RAPcores/rapcores/boards/README

# Pin Definitions

pin difinitions for different boards

Naming?
