RAPcores/rapcores/docs/index.rst

About
=====

RAPcores is an open source project focused on widely deployable FPGA and ASIC hardware 
for high performance closed-loop motor control. RAPcores stands for
Robotic Application Processing Cores.

Contents
--------

.. toctree::
   :maxdepth: 2

   releases
   interfaces
   spi_spec
   register_map
   configuration
   motor_control
   librapcore
   asic
   dev
   internals
