RAPcores/rapcores/docs/librapcore.md

## librapcore

librapcore is the C driver library targeting Linux and embedded devices.

Docs will go here...
