RAPcores/rapcores/(threads)

Thread 2 (2020-07-27):

SPI Protocol Spec

sjkelly, 2020-07-27:
Via Alden:

The following needs to be transferred from the firmware to the FPGA (down) on a per-segment basis

- clock_ticks/segment (32 bit, unsigned) - sets the length of the segment
- direction bit word. Assuming a 6 axis device, that’s 6 bits. Fits in a byte, or a 32bit word if symmetry is required

- per motor. (Assume 6 - for example)
  - sub-step increment (32 bit, unsigned) Sets step rate relative to stepper clock
  - sub-step increment increment (32 bit, signed)
      Sets linear acceleration per step by adjusting sub-step increment up or down

So that’s 14 x 32 bit words = 448 bits

The following should be returned per segment
- per motor
   - incremental shaft encoder reading of previous segment
   - incremental effector encoder reading of previous segment

That’s 12 x 32 bit words returned per transfer. This can be clocked in the SPI back- channel. You have up to 64 bits that can be padded to allow for encoder read setup time if required.

At 1 Mbps that’s 2232 transfers per second (idealized - reality would be a bit slower)
At 8 Mbps that’s 17857 transfers per second
At 25 Mbps that’s 55803 transfers per second

This could very reasonably be handled by a 8 Mbps SPI data rate and still achieve very good update times. Minimum theoretical segment time would be 56 uSec at this rate. We would probably want to run more like 250 uSec or 125 uSec

FYI: Steve's Google doc notes
https://docs.google.com/document/d/1CBAAlIxWcqdrMcA0QrfrJmAGSGN-QBaauAiughXW1mI/edit

sjkelly, 2021-01-06:
Closing this out since the SPI protocol is now implemented and documented close to what is discussed here. Docs: https://rapcores.github.io/rapcores/spi_spec.html

We can open further issues for more granular discussions.

Closed 2021-01-06.

Thread 3 (2020-07-29):

Quad SPI support

sjkelly, 2020-07-29:
Quad SPI seems to be growing more common, especially on cortex m7. Some FPGAs have hard IP for it, but none of these are in open bitstreams tools yet.

Refs:
- https://embeddedinventor.com/quad-spi-everything-you-need-to-know/

sjkelly, 2021-08-12:
I don't think this will ever happen, unless there is accessible hard IP for it. It makes more sense to jump to PCIe for CPU+RAPcore combos, and plain SPI should be sufficient for most embedded applications. I2C also would be far more marketable as well, making QSPI a too specialized niche to address right now.

Closed 2021-08-12.

Thread 6 (2020-08-13):

Stepper Driver Control

sjkelly, 2020-08-13:
The current code runs commutation on a dual HBridge. For early integration with upstream firmwares we should be able to generate step/dir/enable signals.

Closed 2020-12-17.

Thread 7 (2020-08-13):

Bipolar Stepper Motor Commutator

sjkelly, 2020-08-13:
Desired Features:

### Open Loop:

- [x] Current Limit
- [x] Micro Stepping (256 is target)

### Closed Loop:
- [ ] Current Measurement
- [ ] Skip Detection

sjkelly, 2021-06-11:
We hit 256x microsteps for open loop with SVM current limit. Discussion for closed loop in #149

Closed 2021-06-11.

Thread 23 (2020-09-15):

Maximize use of BRAM on FPGA

sjkelly, 2020-09-15:
At present the parameters for the step timer and commutation tables are inferred as gates. This will very quickly become problematic if microstep count or move buffer size increase. E.g. with the move buffer at 2 we are at ~2400 LUT and with it set to 8 we are at ~4000 LUT. Mind this is for a single axis.

Fortunately Yosys will automatically infer memories without instantiating device specific RAM modules. See: https://github.com/YosysHQ/yosys/issues/1134
To do this we will need to limit the block/word size to 16 bits. This should be achievable in the commutator module by keeping the phase PWM resolution under 16 bit. However there are more gymnastics for the step timer to set strides for 64 bits.

sjkelly, 2021-02-21:
I'm closing this out since we now have the opposite problem:

```
25.22.6. Executing MEMORY_COLLECT pass (generating $mem cells).
Collecting $memrd, $memwr and $meminit for memory `$flatten\spifsm.$genblock$src/spi_state_machine.v:147$846[0].\s0.phase_table' in module `\rapcore':
  $flatten\spifsm.$genblock$src/spi_state_machine.v:147$846[0].\s0.$meminit$\phase_table$src/dual_hbridge.v:0$249 ($meminit)
  $flatten\spifsm.$genblock$src/spi_state_machine.v:147$846[0].\s0.$memrd$\phase_table$src/dual_hbridge.v:108$246 ($memrd)
  $flatten\spifsm.$genblock$src/spi_state_machine.v:147$846[0].\s0.$memrd$\phase_table$src/dual_hbridge.v:109$248 ($memrd)
Collecting $memrd, $memwr and $meminit for memory `$flatten\spifsm.$genblock$src/spi_state_machine.v:147$847[1].\s0.phase_table' in module `\rapcore':
  $flatten\spifsm.$genblock$src/spi_state_machine.v:147$847[1].\s0.$meminit$\phase_table$src/dual_hbridge.v:0$249 ($meminit)
  $flatten\spifsm.$genblock$src/spi_state_machine.v:147$847[1].\s0.$memrd$\phase_table$src/dual_hbridge.v:108$246 ($memrd)
  $flatten\spifsm.$genblock$src/spi_state_machine.v:147$847[1].\s0.$memrd$\phase_table$src/dual_hbridge.v:109$248 ($memrd)
Collecting $memrd, $memwr and $meminit for memory `$flatten\spifsm.$genblock$src/spi_state_machine.v:147$848[2].\s0.phase_table' in module `\rapcore':
  $flatten\spifsm.$genblock$src/spi_state_machine.v:147$848[2].\s0.$meminit$\phase_table$src/dual_hbridge.v:0$249 ($meminit)
  $flatten\spifsm.$genblock$src/spi_state_machine.v:147$848[2].\s0.$memrd$\phase_table$src/dual_hbridge.v:108$246 ($memrd)
  $flatten\spifsm.$genblock$src/spi_state_machine.v:147$848[2].\s0.$memrd$\phase_table$src/dual_hbridge.v:109$248 ($memrd)
Collecting $memrd, $memwr and $meminit for memory `$flatten\spifsm.$genblock$src/spi_state_machine.v:147$849[3].\s0.phase_table' in module `\rapcore':
  $flatten\spifsm.$genblock$src/spi_state_machine.v:147$849[3].\s0.$meminit$\phase_table$src/dual_hbridge.v:0$249 ($meminit)
  $flatten\spifsm.$genblock$src/spi_state_machine.v:147$849[3].\s0.$memrd$\phase_table$src/dual_hbridge.v:108$246 ($memrd)
  $flatten\spifsm.$genblock$src/spi_state_machine.v:147$849[3].\s0.$memrd$\phase_table$src/dual_hbridge.v:109$248 ($memrd)
Collecting $memrd, $memwr and $meminit for memory `\spifsm.current' in module `\rapcore':
  $flatten\spifsm.$memwr$\current$src/spi_state_machine.v:0$1084 ($memwr)
  $flatten\spifsm.$memwr$\current$src/spi_state_machine.v:0$1090 ($memwr)
  $flatten\spifsm.$memwr$\current$src/spi_state_machine.v:0$1096 ($memwr)
  $flatten\spifsm.$memwr$\current$src/spi_state_machine.v:0$1104 ($memwr)
  $flatten\spifsm.$memrd$\current$src/spi_state_machine.v:163$1049 ($memrd)
  $flatten\spifsm.$memrd$\current$src/spi_state_machine.v:163$1047 ($memrd)
  $flatten\spifsm.$memrd$\current$src/spi_state_machine.v:163$1045 ($memrd)
  $flatten\spifsm.$memrd$\current$src/spi_state_machine.v:163$1043 ($memrd)
Collecting $memrd, $memwr and $meminit for memory `\spifsm.dir_r' in module `\rapcore':
  $flatten\spifsm.$memwr$\dir_r$src/spi_state_machine.v:0$1075 ($memwr)
  $flatten\spifsm.$memwr$\dir_r$src/spi_state_machine.v:0$1103 ($memwr)
  $flatten\spifsm.$memrd$\dir_r$src/spi_state_machine.v:113$909 ($memrd)
Collecting $memrd, $memwr and $meminit for memory `\spifsm.increment' in module `\rapcore':
  $flatten\spifsm.$memwr$\increment$src/spi_state_machine.v:0$1079 ($memwr)
  $flatten\spifsm.$memwr$\increment$src/spi_state_machine.v:0$1080 ($memwr)
  $flatten\spifsm.$memwr$\increment$src/spi_state_machine.v:0$1085 ($memwr)
  $flatten\spifsm.$memwr$\increment$src/spi_state_machine.v:0$1086 ($memwr)
  $flatten\spifsm.$memwr$\increment$src/spi_state_machine.v:0$1091 ($memwr)
  $flatten\spifsm.$memwr$\increment$src/spi_state_machine.v:0$1092 ($memwr)
  $flatten\spifsm.$memwr$\increment$src/spi_state_machine.v:0$1097 ($memwr)
  $flatten\spifsm.$memwr$\increment$src/spi_state_machine.v:0$1113 ($memwr)
  $flatten\spifsm.$memrd$\increment$src/spi_state_machine.v:97$1069 ($memrd)
  $flatten\spifsm.$memrd$\increment$src/spi_state_machine.v:97$1063 ($memrd)
  $flatten\spifsm.$memrd$\increment$src/spi_state_machine.v:97$1057 ($memrd)
  $flatten\spifsm.$memrd$\increment$src/spi_state_machine.v:97$1051 ($memrd)
Collecting $memrd, $memwr and $meminit for memory `\spifsm.incrementincrement' in module `\rapcore':
  $flatten\spifsm.$memwr$\incrementincrement$src/spi_state_machine.v:0$1081 ($memwr)
  $flatten\spifsm.$memwr$\incrementincrement$src/spi_state_machine.v:0$1082 ($memwr)
  $flatten\spifsm.$memwr$\incrementincrement$src/spi_state_machine.v:0$1087 ($memwr)
  $flatten\spifsm.$memwr$\incrementincrement$src/spi_state_machine.v:0$1088 ($memwr)
  $flatten\spifsm.$memwr$\incrementincrement$src/spi_state_machine.v:0$1093 ($memwr)
  $flatten\spifsm.$memwr$\incrementincrement$src/spi_state_machine.v:0$1094 ($memwr)
  $flatten\spifsm.$memwr$\incrementincrement$src/spi_state_machine.v:0$1099 ($memwr)
  $flatten\spifsm.$memwr$\incrementincrement$src/spi_state_machine.v:0$1114 ($memwr)
  $flatten\spifsm.$memrd$\incrementincrement$src/spi_state_machine.v:98$1072 ($memrd)
  $flatten\spifsm.$memrd$\incrementincrement$src/spi_state_machine.v:98$1066 ($memrd)
  $flatten\spifsm.$memrd$\incrementincrement$src/spi_state_machine.v:98$1060 ($memrd)
  $flatten\spifsm.$memrd$\incrementincrement$src/spi_state_machine.v:98$1054 ($memrd)
Collecting $memrd, $memwr and $meminit for memory `\spifsm.microsteps' in module `\rapcore':
  $flatten\spifsm.$memwr$\microsteps$src/spi_state_machine.v:0$1083 ($memwr)
  $flatten\spifsm.$memwr$\microsteps$src/spi_state_machine.v:0$1089 ($memwr)
  $flatten\spifsm.$memwr$\microsteps$src/spi_state_machine.v:0$1095 ($memwr)
  $flatten\spifsm.$memwr$\microsteps$src/spi_state_machine.v:0$1105 ($memwr)
  $flatten\spifsm.$memrd$\microsteps$src/spi_state_machine.v:162$1048 ($memrd)
  $flatten\spifsm.$memrd$\microsteps$src/spi_state_machine.v:162$1046 ($memrd)
  $flatten\spifsm.$memrd$\microsteps$src/spi_state_machine.v:162$1044 ($memrd)
  $flatten\spifsm.$memrd$\microsteps$src/spi_state_machine.v:162$1042 ($memrd)
Collecting $memrd, $memwr and $meminit for memory `\spifsm.move_duration' in module `\rapcore':
  $flatten\spifsm.$memwr$\move_duration$src/spi_state_machine.v:0$1077 ($memwr)
  $flatten\spifsm.$memwr$\move_duration$src/spi_state_machine.v:0$1106 ($memwr)
  $flatten\spifsm.$memrd$\move_duration$src/spi_state_machine.v:89$908 ($memrd)
```

Closed 2021-02-21.

Thread 44 (2020-10-21):

Switch some Bits to 32 bit

sjkelly, 2020-10-21:
Some rough math on encoders:

```
julia> 2^32/10000 # 10k CPR encoder
429496.7296
```
That covers 429 meters of travel at 1mm/rev.

The SPI protocol in master is not inline with the [proposed spec](https://github.com/RAPcores/Ulticores/wiki/MSG-0x01:-coordinated_segment) either. Master is a separate 64 bit word for duration and 54 bits for direction.

sjkelly, 2021-02-12:
Mostly addressed. Will need some config cleanup (part of define -> parameter transition), but the overrides are there.

Closed 2021-02-12.

Thread 47 (2020-10-23):

Status Words

sjkelly, 2020-10-23:
These will be for all transactions so they have to be general:

<table>
<tr>
<th rowspan="2">I/O</th>
<th colspan="8">Word 1 (Control / Status)</th>
</tr>
<tr>
<th>B1</th> <th>B2</th> <th>B3</th> <th>B4</th> <th>B5</th> <th>B6</th> <th>B7</th> <th>B8</th>
</tr>

<!-- left header-->
<tr><th>CO</th>

<!-- word 1-->
<td><code>0x01</code></td>
<td><code>RESERVED</code></td>
<td><code>0bPONM_LKJI</code></td>
<td><code>0bHGFE_DCBA</code></td>
<td colspan="4"><code>dda_ticks</code></td>

</tr>

<tr>
<!-- left header-->
<th>CI</th>

<!-- word 1-->
<td colspan="1">Status word is TBD</td>

<td colspan="1">Status word is TBD</td>
<td colspan="1">Status word is TBD</td>

<td colspan="1">Status word is TBD</td>
<td colspan="1">Status word is TBD</td>
<td colspan="1">Status word is TBD</td>
<td colspan="1">Status word is TBD</td>
<td colspan="1">Number of available buffer spaces</td>
</tr>
</table>

sjkelly, 2021-07-19:
We have a status register now that is an alternative solution to this. We can still add status words as part of the header transaction over SPI, but it is a special case, and not strictly required for our needs.

Closed 2021-07-19.

Thread 76 (2020-12-03):

RAM Memory Mapping and Module Communication (for Buffering)

sjkelly, 2020-12-03:
So far I think we have got our bearings on how to use the distributed block RAMs on the FPGA. However, there are also larger memories available. Now going through the process of ASIC hardening and modularization has lead to some potential insights:

- We have alot of memories and wide registers
- We will only have more of these as we get to MVP
- The initialization of registers is mostly zero, but in some cases it is a constant

OpenRAM docs and technology: https://vlsida.github.io/OpenRAM/

IIUC, BRAM in FPGA is pre-initialized at bitstream load so it almost behaves like a register. I'm not sure what pre-initialized OpenRAM memory would look like and require.

The benefits of RAM over distributed registers (FPGA and ASIC):
- Structure in ASIC and density -> less die area
- Known timing behaviours
- Validated on a given technology process
- Possibly fewer gates within a module

However they likely need to be:
- Initialized
- Manually Placed (in the ASIC hardening process)
- Controlled both at the ASIC level and high-level state machine level

Now in several spots we have a pseudo-memory -> register hierarchy. Examples: Cosine, DDA Timer (parameter load from double buffer). In most cases they are BRAMs or all registers. Successfully utilizing BRAMs in all these cases could be a simple demonstration of what is needed. E.g. if BRAMs work we may have a mapping from FPGA -> ASIC via OpenRAM.

That is where I am at now in understanding this. As to what needs to be done; this is not yet clear to me. I suspect when we have RV32 integration it will be more clear about how to handle transfers and events. This should give clarity on memory mapping between RV32<->RAPcore as well.

This is slightly different from #23 because this is more to the ASIC hardening process. #23 is a prerequisite for these things.

sjkelly, 2021-02-21:
This is addressed with RAM use at the moment. The alternative of using a bus is #128

Closed 2021-02-21.

Thread 81 (2020-12-07):

Formal is not running for Ultibridge

sjkelly, 2020-12-07:

sjkelly, 2021-02-24:
This and #83... Symbiyosys is effectively a wrapper over `yosys` and `yosys-smtbmc`. Possible option may be to extract the flow so that it fits into our build system better and we can change out configs.

sjkelly, 2021-02-24:
Or just append the board defines like so: https://symbiyosys.readthedocs.io/en/latest/reference.html#file-sections

Closed 2021-02-24.

Thread 83 (2020-12-07):

Remake formal board specific

sjkelly, 2020-12-07:
Seemed like a good idea at the time. Then i blew up my board.

Closed 2021-02-24.

Thread 114 (2020-12-21):

In-tree ASIC/FPGA synthesis+techmap for test benches

sjkelly, 2020-12-21:
This would be helpful for high-level isolated gate-level tests outside openlane or other open source PDK flows.
Examples: https://github.com/YosysHQ/yosys/tree/master/examples/osu035

We would likely need to use open_pdks to get the liberty files for ABC using Skywater.

Uncertainties:
- Powered Verilog
- EDIF to verilog (netgen?)
- GL synth/TB is possible for ASIC. Same for FPGA?
- Prebuilt liberty files?

Slight prerequisite for this is #42 such that we have self-checking test benches.

sjkelly, 2021-03-06:
Waiting pays:

sjkelly, 2021-03-06:
https://github.com/efabless/skywater-pdk-libs-sky130_fd_sc_hd

Thread 118 (2020-12-23):

Document Release Process

sjkelly, 2020-12-23:
With the skywater shuttle out there now we officially have a deployment target for 0.1. In order to address some current issues and continue development, we need to break naming on some files while also stabilizing and testing the skywater deployment.

Since we have committed to semantic versioning a 'main/develop' give insufficient space for all possible versions.

Rough guideline:
- `main` -> active development branch
- `release-M.m` -> stabilized/frozen release branches

So e.g. we branch off main as `release-0.1`. Main now targets 0.2 active development. Changes/patches from 0.2 that are API compatible can be backported to the `release-0.1` branch. In this case a new patch release is made such as `0.1.0` -> `0.1.1`.

sjkelly, 2021-01-06:
#125

Closed 2021-01-06.

Thread 120 (2020-12-23):

Step out signal too short a length

johnnyr, 2020-12-23:
The Step out signal is very short. We should probably make the signal be on for multiple clock cycles.

aldenhart, 2020-12-23:
Most drivers require at least 1uS, and 10uS is a better comfort zone. SOme really old drivers (like some Toshibas) want even more than that.

sjkelly, 2021-01-15:
Some datasheet surfing:

| Part | Min Step High (ns)|
|-------|--------------------------|
| A4988 | 1000 |
|TMC2160| 100|
|DRV8825| 1900|

With #130 the pulse duration is 1/(DDA tick) currently set to 400khz so 2500ns.

Closed 2021-01-15.

Thread 128 (2021-01-08):

Inter-Module Configuration passing

sjkelly, 2021-01-08:
Current work on multiaxis support is leading to some issues with passing configurations between modules. This is likely part of our on-going understanding of how to use memories effectively and RTL design patterns. There was some offline discussion of an inter-module bus architecture. The downsides are this may add additional gates/LUTs. The upside is this would greatly simplify macrofying a driver module on ASIC.

Filing this as an issue because it is likely best to get multi axis in ASAP for integration test and hack around this until we find a proper solution.

sjkelly, 2021-02-15:
Somewhat philosophical point:
Verilog Modules are intended (at least as far as I can tell) to be logical abstractions and physical black boxes. Now for ASIC hardening we need to plan somewhat in advance what we want to harden separately. During the eFabless MPW-one we tried both a hyper-modularized approach, somewhere inbetween, and a "monolith". Ultimately the monolith was shipped, but I think that we all agreed that it was not a satisfying solution.

The core issue with the FSM and modularization is that *memories cannot be passed in and out of modules*. To really get multiaxis into the protocol we need either a bus on each module to pass configuration or we need to instantiate them alongside the FSM. Instantiating along side the FSM is the simplest solution and likely uses the fewest resources. A bus is satisfying from a re-use and validation standpoint.

I am proposing we punt the bus issue to work on the SPI user-facing APIs, and make the statemachine at the top-level again. So leave this an open issue, but fix the core issue which is getting per-axis parameters (such as current and microsteps) supported ASAP.

sjkelly, 2021-05-08:
The module layout we have now works well, and is similar to what was described in my last comment. I think some modules may eventually warrant their own bus, but for now everything is arranged such that the memories work well for multi axis control. We will eventually need some way of using and managing these memories more effectively, but the root issue here is addressed.

Closed 2021-05-08.

Thread 134 (2021-01-16):

[DDA] Flip substep acculumator on direction change

sjkelly, 2021-01-16:
https://github.com/synthetos/g2/blob/441003f36ed4fc13a7ddefb61c0db4fecc67a463/g2core/stepper.cpp#L521-L529

Closed 2021-07-19.

Thread 146 (2021-02-12):

Jitter in DDA

sjkelly, 2021-02-12:
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

with `make yosys-rapcore` on sjk/ms1 branch.

Closed 2021-02-20.

Thread 148 (2021-02-16):

Encoder and Microstep Modulus

sjkelly, 2021-02-16:
e.g. for a 1000cpr encoder with 200 steps/rev and 64 microsteps we have 64 microsteps and 5 encoder ticks per full step then 12.8 microsteps per encoder tick.

We could possible handle a few ways:
- Microsteps become divisible by 10 e.g. 60 microsteps
- Use a lookup table for phasing increments e.g. {12, 13, 13, 13, 13} for the above example
- Compressed version of the above, in words "13 microsteps per tick, but every 4 ticks it is 12".

None of these seem satisfactory, hence an issue to noodle and get some comments.

Thread 149 (2021-02-17):

Closed Loop Modes

sjkelly, 2021-02-17:
Some ideas of parameters for closed loop:

Vector space
- Square (will detent, but better holding torque)
- Circle (smooth in theory)

Over Torque
- Throttle all motor channels ( not sure how to do)

Positioning
- Phase hold (normal)
- FOC (unstable)
- "Soft" allow a deadband of +/- 90 degrees

Current bounds
- Min/Max

Thread 153 (2021-02-20):

Explicit Motion Timing Protocols and Current Controllers

sjkelly, 2021-02-20:
With the microstepping work on main we now have the ability to dynamically alter currents as part of motion planning. The current DDA could be expanded to support these modes. An alternative that may dovetail better with other firmwares and frameworks would be an explicit timing mode (whereas DDA is an implicit form). We would need to specify:

- Duration
- Clock ticks/step
- Delta clock ticks/step
- Initial current
- Delta current/step

Wild Speculation:

The main hypothesis is that we are better served using high level dynamics modeling to regulate current (as an analogue for joint torques). Part of this is that the state space for torque control on the motor is two dimensional (rotation and vector length), making a simple PID controller inadequate. PID is sufficient for isolated cases, but we know from low-cost servo options that PID suffers from instability at given velocity windows.

For BLDC this issue is alleviated to some extent by driving the motor at high RPM with high gear ratios. Steppers cannot do this. Moreover, FOC on a stepper has far fewer encoder ticks per electrical cycle (or phase) than a BLDC. This means the error term derived from the encoder is far lower resolution than the number of divisions of our space vector (e.g 5 ticks vs 64 microsteps).

That is not to say controllers in rapcores is not possible or valuable. One approach in rapcores maybe to use a PID or other simple controller to alter the current vector if the encoder is showing lag in the system due to load as a last resort. We will still need an external controller to adjust the velocities and torques periodically (e.g control the angle element of the controls problem). But I think a far more powerful approach is to develop a state space from the torque data during a move to improve the dynamics models on the fly, obviating the need for a controller in rapcores. Given a 1khz update rate we will generate gigs of data that could be used to implement this type of controller.

Links:

- https://www.machinedesign.com/automation-iiot/article/21826706/20-minute-tuneup-zoning-in-on-position-loops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,calculate%20the%20corresponding%20following%20error.&text=The%20greater%20the%20position%20error,a%20direction%20reducing%20the%20error.
- https://www.machinedesign.com/automation-iiot/article/21828255/20-minute-tuneup-put-a-pid-on-it
- https://www.machinedesign.com/home/contact/21838863/motion-system-design

sjkelly, 2021-02-21:
XRef #149

Adding to 0.2 milestone

sjkelly, 2021-05-08:
I'm was conflating two things here. Fixed point is not antithetical to current interpolation, so my reasoning is flawed. Also increasing the DDA base frequency would address my point of BLDC drive frequency as well. Upon more investigation, fixed point is the only way to achieve good precision. I think when I wrote this I was worried that LUT use of the DDA would prevent additional control parameters and I was looking at simpler examples. LUT use shouldn't be a hard constraint yet. Since this issue, we have documented some basic stepper motor models, so the controls intuition I originally wrote here is mostly correct, but it is a subset of wider control solutions. We may let the path planning software implement a control, or we can do onboard, both are valid. Nothing is concretely actionable here or a real concern anymore, so I am closing.

Closed 2021-05-08.

Thread 168 (2021-02-26):

SPI Tristate Broken on Gowin

sjkelly, 2021-02-26:
Title

Thread 170 (2021-02-27):

Upstream Issues notes

sjkelly, 2021-02-27:
Should probably file these upstream (yosys, nextpnr, etc). Most will need minimal repros:

- [ ] Ice40 PLL/Package issues (#152)
- [ ] VCD outputs incorrect wire width when resized via parameter

Thread 171 (2021-02-27):

32 Bit protocol variant

sjkelly, 2021-02-27:
Starting the work on this, for the sake of testing if we parameterized everything well (we are close) and try to find some bugs (I did). Speculative bonus is fewer gates and more throughput.

Implications are minimal. Some wide instructions such as microstepper config use the full 56 bits (64 - 8 for header). DDA etc only loose precision. Of course the current DDA motor support will also drop from 56 motors to 24.

sjkelly, 2021-04-16:
I don't think this makes sense to support at this point in SPI. 64 bit internal words on the FSM are likely to be okay. The original idea was to better abstract the communication layer from the FSM, which is now finished.

Closed 2021-04-16.

Thread 172 (2021-03-01):

SPI Bus Issues

sjkelly, 2021-03-01:
https://github.com/RAPcores/rapcores/commit/1153917c83957df55c1a7e642a8e2507e588b8aa

Thread 183 (2021-03-22):

Encoder Velocity and Acceleration Estimates

sjkelly, 2021-03-22:
Will likely be useful for solving for Inertia and dampening. Also we should be able to trivially do stall detection with a velocity threshold.

From our example Frequency table for Prusa MK3s the homing full step frequency is 300Hz. which gives us 1.5kHz using a 1000 cpr encoder. Assuming constant velocity, if in a 1/1500 second period (likely + some error bound) occurs without a position update we can infer a stall.

Thread 189 (2021-04-01):

Apply Microsteps as a denominator rather than quotient

sjkelly, 2021-04-01:
We currently do this:
```
  // Set the increment across the phase table from the specified microsteps
  wire [7:0] abs_increment = (microsteps == 8'd0 ) ? 8'd64 :
                             (microsteps <= 8'd2 ) ? 8'd32 :
                             (microsteps <= 8'd4 ) ? 8'd16 :
                             (microsteps <= 8'd8 ) ? 8'd8  :
                             (microsteps <= 8'd16) ? 8'd4  :
                             (microsteps <= 8'd32) ? 8'd2  :
                                                     8'd1  ;
```

In theory non power of two increments should work in LUT traversal. so you could e.g. get 64/3 microsteps. Which might be useful for encoders and also less FPGA logic.

sjkelly, 2021-04-01:
This is a proposed solution for #148

Closed 2021-04-03.

Thread 190 (2021-04-01):

VFD Starting Coils - Observations

sjkelly, 2021-04-01:
While making the SVM parametric I realized we are close to making a VFD. I have a motor from a fan here that has a starting coil. Some observations:

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

Here the Primary (blue) has a much greater magnitude than the starting coil in red with a slight phase shift.

For the SVM to be suitable for one phase VFD with starting coils we will likely need to apply different current scaling to each coil and arbitrary phase shifts.

sjkelly, 2021-07-27:
SVM is now able to handle this by making the amplitude a vector.

Closed 2021-07-27.

Thread 191 (2021-04-05):

CRC and/or 8b/10b encoding

sjkelly, 2021-04-05:
I'm running some simple checks since we now have librapcores for high throughput transfers. I'm observing relatively high error rates on the bench of ~1-2%. The hardware setup is non-ideal, long cables, etc. This should be a good worst-case for error correction tests. After looking at some other devices I am noticing CRC is commonly used for user-space protocols.

8b/10b is also used with CRC, but it appears generally at physical layers and it high end buses like PCIe and USB3, so it may be expensive to do this in software. OTOH, 8b/10b could just be a lookup table ~1kB and may still achieve good performance for processors with sufficient cache, but I'm not sure things like microcontrollers would be able to do this well. So far I have not seen this done in userspace software, so it would be experimental and risky. We will likely want to revisit this at some point.

The issues and risks to CRC are the transfer process. Since we have "stream" modes such as coordinated moves, we need to be certain the header is ACK before proceeding with the stream payload, or we may accidentally trigger a different mode in the state machine. It is therefore likely easiest to do CRC on each 64bit word at a time. The performance implications of this in host controller software will need to be quantified some how. On the gateware sides of things this can be done non-combinatorially (see pony link below), so we should not introduce latency on the peripheral side of things. Gateware should also have no state machine changes, with CRC checks and error handling residing in the SPI bus module.

A good reference for a CRC + 8b/10b protocol with Verilog and C code: https://github.com/cliffordwolf/PonyLink

sjkelly, 2021-04-05:
Verilog CRC generator:

http://outputlogic.com/?page_id=321

Thread 202 (2021-05-06):

Three Phase SVM Alignment

sjkelly, 2021-05-06:
Currently we center align all 'N' phases requested of the SVM. This is AFAIK incorrect for three phase by the property that A+B+C=0, U+V+W=0. In any given point of the three-phase electrical cycle, two phases should sign match. So these likely need to be "stacked" in some form such that they are equal to the single opposite signed phase.

What we have:
```
    // A: |-------|____
    // B: ___|-|_______
    // C: _|-----|_____
```

What we need:
```
    // A: |--------|___
    // B: ____|-|___
    // C: |-----|_____
```

sjkelly, 2021-05-06:
e.g:
https://github.com/bgkatz/motorcontrol/blob/2fa6cabbebcb19efb9d6b2dd0f59edc3537ad64f/Core/Src/foc.c#L96-L107

sjkelly, 2021-05-13:
We also need the DQ transform from here: https://github.com/bgkatz/motorcontrol/blob/2fa6cabbebcb19efb9d6b2dd0f59edc3537ad64f/Core/Src/foc.c#L83-L94

Thread 205 (2021-05-11):

Register Map

sjkelly, 2021-05-11:
With the recent work to use parametric style verilog, I believe there is a stronger case for https://github.com/RAPcores/rapcores/pull/154. The root issue of that approach is that most data was made redundant. Only certain things are true "memories" in RAPcores, namely: DDA buffer, and microstep tables. Everything else is registers, so efficient memory packing and extraction should not save any gates.

However, I suspect that this memory-packed approach is still correct, and may be generalized to a net benefit. To achieve this benefit, the state machine and protocol will likely need to be changed out into a true "register" model that uses this packed memory structure. The key savings will be a slimmed-down FSM that simply writes to a memory address. I've been nibbling around the edges of this idea for a few months now under the auspice of a "async" state machine. The reality is we are already async, but I realize now we may rework the protocol to maintain the same latency and bandwidth balance with a greatly reduced FSM complexity.

The approximate approach is as follow:
Header Modifications:
- Eliminate any data transfer in the header.
- Add Read/Write Flags to the header
- Add a transfer length field

This is more similar to SPI flash interfaces.

Next we will have to:
- Construct a parametric register map with localparam offsets.
- Communicate alignment/register locations to `librapcores`

The combination of these should make the main communication state machine only require a few states, rather than the "state-per-command" as implemented currently.
Moreover, values that do no require registers (such as the aforementioned offsets, version numbers, configuration data, etc) will also be elided as memory access (rather than wasting LUT like we do currently).

Of course its hard to completely eliminate the complexity, we just shove it somewhere else. Librapcores will need to handle these offsets. Fortunately though, I think doing this on CPU is a much better place than in gateware as we do now.

sjkelly, 2021-05-17:
I did some more research on this over the weekend, and was pretty inspired by the Friday OpenFPGA presentations. The wishbone bus transaction state (or any SoC bus) is close to what we want for minimal footprint and device utilization (Address, Data In, Data Out, Read/Write flag, ACK, etc)  The difference is we have different event timing with SPI and are missing a dedicated address line. However, an internal wishbone bus is likely the best long-term pathway here for future integration. For example QuickLogic is using OpenFPGA for all their new products, and we would have a simple pathway to becoming HardIP on an eFPGA if we support Wishbone,  (disclaimer: I'm a QuickLogic shareholder). Same story for PicoSoC, Caravel, etc...

So the objective is multifold:
- We need to test a register mapping strategy to handle more readable and writable registers than the present.
- We need to slim down the FSM
- We should have a strategy for multiple interfaces and protocols
- We should handle memories more effectively than the present
- We need to support SoC/Hard IP integration uses of RAPcores

Internally, it seems like wishbone is likely the lowest common denominator that is easily achievable, and addresses the above. We could use our own internal bus and treat Wishbone/SPI/etc non-preferentially.

However, and one-to-one mapping of Wishbone bus to SPI will not be a good outcome for latency and bandwidth. We therefore will likely need to implement some form of a compressed protocol in any non-wishbone bus (something like described in my prior comments would work nicely for this). This should have minimal impact on SPI operations, however we will need to put more logic in the SPI layers. Most of the SPI protocol layer should consist of simple offset and read/write handling to the bus based on the header packet, so the complexity should be manageable.

Some possible consequences of SPI interfacing with Wishbone:
- While Wishbone does have a 64 bit standard, 32 bit is more common.
- If we allow memory offsets for transmission and reception (e.g. CMD 0x01 when DDA params in, encoders out), we may need two cycles on the FSM.
- Will we actually save anything by simplifying the FSM and later complicating the SPI?

Proposed evolution:
- Start with a basic register map and see if a select grouping of commands can be elided from the FSM.
- Rework SPI protocol along the way to be more memory-oriented
- Rework the `spi_state_machine` to be `wishbone_state_machine` and use 32 bit words internally.

sjkelly, 2021-05-17:
@tonokip suggests that we make the mode like a DMA on the SPI bus. Rather than specify length we do implicit address increments on each preceding word. The address increment is performed until CS is deasserted.

sjkelly, 2021-06-04:
We are heading into murky territory here. This is a good article that echoes much of what I've researched so far:
https://olofkindgren.blogspot.com/2016/11/ip-xact-good-bad-and-outright-madness.html

There are some tools to show what is possible:
https://airhdl.com

Though AirHDL is AXI, not wishbone.

From a project perspective, I am not seeing many opportunities to automate register maps. For example, few opensource SoC have automated register mapping (e.g. generate C Header, Verilog, and Documentation). That is read as "there are no good open source tools for this", and from what I've read "there are no good tools for this" seems also like an accurate statement.

Three things need to be kept accurate:
- Documentation
- C Bindings
- Verilog Code

Doing this manually for now is likely an acceptable practice so we can get this development moving and at least feel _somewhat_ comfortable with the foundation here. Long term, we will likely have to see how this plays out. I will open up a new issue to track automating this while we move forward with a manual implementation.

sjkelly, 2021-06-16:
May be good to also think about how strided access patterns could help here. #212 implements something DMA-like, but the addressing is a mess. WB natively support "granularity" which is like a stride, but for a single transaction.

sjkelly, 2021-06-30:
With #212 merged (and improved since my last comments) I think we have a decent handle on this and can move towards Wishbone/SoC deployments.

Closed 2021-06-30.

Thread 206 (2021-05-11):

Carry Chains and Fixed Point for mixed mode controls

sjkelly, 2021-05-11:
This is a thought experiment around the problem of step timing and commutation. I don't think this is strictly reasonable as described. It is grossly over simplified, but I feel it is worth articulating to elaborate the basic concepts of carry-chains and fixed point, and keep these concepts in mind for future projects and features.

The basic idea of the DDA is to trigger a "rollover" in an accumulator at some fixed point. A well-known form of the DDA in digital design is the Delta Sigma Modulator. Both are types of fixed-point schemes, and important for bresenham algorithms and frequency dividers. A simple 8 bit verilog example:
```
module delta_sigma(clk, PWM_in, PWM_out);
input clk;
input [7:0] PWM_in;
output PWM_out;

reg [8:0] PWM_accumulator;
always @(posedge clk) PWM_accumulator <= PWM_accumulator[7:0] + PWM_in;

assign PWM_out = PWM_accumulator[8];
endmodule
```
Source: https://www.fpga4fun.com/PWM_DAC_2.html

The DDA uses a similar fixed point scheme to generate "step" signals. The key observation here is that these step signals need to be accumulated again somewhere. Currently we use 64 bits for DDA accumulator, or the "sigma" in delta sigma. Likewise we use a N-bit encoder internal to our commutation routines to determine electrical phasing and location. This is done by using the bottom bits of our encoder for quarter-wave electrical phasing, with the next two bits to determine the phase polarities.
E.G.

| Encoder Top Bits | Phase/quadrant | Microstep Phase/ Quarter wave location|
|------------------------|-----------|------------------------------------------------------|
| N Bits                  | 2 Bits    | 8 bits for 256 microsteps                        |

Now, when we increment or decrement the "encoder" we can determine the change to the electrical phase by looking at the 10 bottom bits. However we could simply chain the DDA and electrical encoder into one large register to complete the fixed point scheme:

| Encoder Top Bits | Phase | Microstep Phase/ Quarter wave location| DDA Accumulator |
|------------------------|-----------|------------------------------------------------------|-------------------------|
| N Bits                  | 2 Bits    | 8 bits for 256 microsteps                        |  64 Bits                 |

~With this approach the Fixed Point scheme is fully embedded into the motor commutation, with the side effect of doubling our DDA resolution. For example, so take one step per DDA tick we would add `typemax(UInt64)` to the accumulator, which will increment our microstep phasing by one each tick. To change direction we subtract. Note: this register is behaving as one big 96bit number assuming 32 bits for electrical encoder, and 64 for the accumulator.~

~This seems like a nice simplification, but there are issues. Primarily this does not cleanly handle variable microsteps. It may also make it difficult to add controllers. Both things we need.~

sjkelly, 2021-05-14:
Some clarifications after implementing in #207.

We use 63 bits for the DDA, since the fixed point component is (naturally) unsigned. The DDA input remains a signed 64 bit number, and the rollover behavior should be the same.

Controls should actually be _far_ easier with this approach. We can easily mix explicit and implicit timing domains, since we have both representations in one place now. E.G. if the DDA is controlling we let it set the accumulator. If we are going something based on encoder velocity/accelerations (based on clock ticks/ encoder step) such as a "skate" mode or torque limited we add to the upper bits, rather than the DDA fixed point.

Naturally, our initial controllers will need to be explicit-timed to be resource efficient. However, in the future, our controls could use the DDA and achieve huge orders of magnitude precision increase.

With variable microsteps, one approach is to window-off bits and shift the DDA terms. There are actually a few approaches here we should consider here, but I consider this low priority compared to servo controls.

Following: https://en.wikipedia.org/wiki/Q_(number_format)
We use a Q24.63 number format in #207.

Closed 2021-07-19.

Thread 218 (2021-07-17):

Register Layouts and Parametrics: Blocked Regions

sjkelly, 2021-07-17:
With the base register map work in main, there is still much to do around the documentation and bindings for this work. One issue that seems nice in practice, quickly becomes a headache is parametric register layouts.

Parametric register layouts are not something that helps interoperability towards any end right now. In theory there is some argument about memory savings and so forth. But I think in practice this is minimal advantage, as I will describe below.

For simplicity we add a new parameter for `max_channels`, and cap it at 16 or 32 for example. This way we "block" out memory space for up to a maximum supported motor channel amount. This still allows for some degree of parametrics, but it will be far simpler, and can likely be a constant for a given version series. For different and custom deployments it can easily be changed, assuming headers and so forth are regenerated. Blocking out channel memory should have minimal effect on LUT count, and may only start posing an issue if we are in 32 bit systems close to 4GB RAM (at which point most systems go 64 bit, so rare case to bend over backwards for).

Argument as to why memory savings argument is wrong: Take the statically compiled case. If we set e.g. four motors as the configuration, we can still achieve memory savings even in the blocked cases, by only allocating arrays needed for our motor subset. The only potential issue is we don't have one-to-one memory mapping anymore, but I suspect 99.9% of transactions will happen in the command channel, so it is completely moot. We still achieve the memory savings and so forth.

In deployment with a lot of system RAM (order of gigs), we are only asking for around 2Mb for a one-to-one memory map, which is not a lot.

In reality this is likely a question of where do we want to punt the complexity. Right now we spread it over the whole stack. If we block out multi-channel regions, we move this out of the hardware and into the software (_if it is desired_). For SMBCs, Python, ROS, we don't have to do anything and have made our life easier. For embedded deployments there is some lost optimization in one-to-one memory maps. This is a classic memory/compute tradeoff. Fortunately the scales of data handled here are so small, I think we will be fine in the long run.

Addendum:
The poo-poo complexity is in SPI embedded systems for mostly status and config registers due to loosing a one-to-one map if trying to save memory. Systems where we are soft-core, eFPGA SoC, etc, we don't have any worries here because we are sharing memory space, and any issues are only going to be noticed in 32Bit/4Gb systems mentioned above. As for address width, we may run past 8 bits for CSR using a block approach. So far the only system I have seen with 8 bit address and 32 bit value lines are the QuickLogic. I suspect this is not common, and something that will pose a general issue when trying to target eFPGA-SoC.

So the ask is: What is an acceptable upper bound on motors to support?

sjkelly, 2021-07-17:
I am calling these "blocks", but "regions" is also a common term.

sjkelly, 2021-07-19:
It seems the consensus was that 32 motors should be a sufficient upper bound for motor channel memory regions. This is not a hard limit, but an attempt at ensuring status and config registers can be common for any device under this threshold. Commands and telemetry will still be resized based on the motor count.
cc @tonokip @johnnyr

johnnyr, 2021-07-20:
Yes. That is what I heard also.

sjkelly, 2021-07-25:
Update: 32 motors and 64 encoders. Allowing 2 encoders per channel for series elastic actuators or the "shaft"/"effector" dichotomy.

sjkelly, 2021-07-27:
Some other verbiage that may have helped my initial explanation is virtual vs physical memory. By growing our register allocations, regardless of use, we need more virtual memory space.

Thread 228 (2021-08-15):

Vector Execution Model Documentation

sjkelly, 2021-08-15:
One of the key properties in RAPcores is low (no) jitter/skew across multiple axes. We also produce outputs that allow construction of a Frenet frame, that should satisfy the basic requirements for dynamic analysis and control. These need to be documented.

Thread 229 (2021-08-18):

Phase angle interface and step input

sjkelly, 2021-08-18:
cc @tonokip @johnnyr

One of the tradeoffs that had to be made for fixed point carry chains was the elimination of a simple step and direction interface. As far as I can tell Ultibridge/RAPbo has bit rotted and is broken with the DDA. Synth doesn't complain on CI which I suspect is due to the configuration also having the STEP_INPUT interface enabled.

Conversely on Dual H Bridge drivers the STEP_INPUT is also broken.

sjkelly, 2021-08-18:
I would like to delete the STEP_INPUT all together. It seems unnecessary since the FPGA does a way better job at this, and we have proved out 64 bit precision is very much so feasible on only a few dollar part.

sjkelly, 2021-08-19:
Now if we for some reason have a valid use case for STEP_INPUT we can just add to the fixed point register on each pulse.
