RAPcores/rapcores/src/top.v

`default_nettype none

module top (
    input  CLK,
    `ifdef LED
      output wire [`LED:1] LED,
    `endif
    `ifdef tinyfpgabx
      output USBPU,  // USB pull-up resistor
    `endif
    `ifdef SPI_INTERFACE
      input  SCK,
      input  CS,
      input  COPI,
      output CIPO,
    `endif
    `ifdef DUAL_HBRIDGE
      output wire [`DUAL_HBRIDGE:1] PHASE_A1,  // Phase A
      output wire [`DUAL_HBRIDGE:1] PHASE_A2,  // Phase A
      output wire [`DUAL_HBRIDGE:1] PHASE_B1,  // Phase B
      output wire [`DUAL_HBRIDGE:1] PHASE_B2,  // Phase B
      output wire [`DUAL_HBRIDGE:1] VREF_A,  // VRef
      output wire [`DUAL_HBRIDGE:1] VREF_B,  // VRef
    `endif
    `ifdef ULTIBRIDGE
      output CHARGEPUMP,
      input analog_cmp1,
      output analog_out1,
      input analog_cmp2,
      output analog_out2,
      output wire [`ULTIBRIDGE:1] PHASE_A1,  // Phase A
      output wire [`ULTIBRIDGE:1] PHASE_A2,  // Phase A
      output wire [`ULTIBRIDGE:1] PHASE_B1,  // Phase B
      output wire [`ULTIBRIDGE:1] PHASE_B2,  // Phase B
      output wire [`ULTIBRIDGE:1] PHASE_A1_H,  // Phase A
      output wire [`ULTIBRIDGE:1] PHASE_A2_H,  // Phase A
      output wire [`ULTIBRIDGE:1] PHASE_B1_H,  // Phase B
      output wire [`ULTIBRIDGE:1] PHASE_B2_H,  // Phase B
    `endif
    `ifdef QUAD_ENC
      input [`QUAD_ENC:1] ENC_B,
      input [`QUAD_ENC:1] ENC_A,
    `endif
    `ifdef BUFFER_DTR
      output BUFFER_DTR,
    `endif
    `ifdef MOVE_DONE
      output MOVE_DONE,
    `endif
    `ifdef HALT
      input HALT,
    `endif
    `ifdef STEPINPUT
      input STEPINPUT,
      input DIRINPUT,
    `endif
    `ifdef STEPOUTPUT
      output STEPOUTPUT,
      output DIROUTPUT,
    `endif
);

  // Global Reset (TODO: Make input pin)
  //wire reset;
  //assign reset = 1;
  `ifdef tinyfpgabx
    // drive USB pull-up resistor to '0' to disable USB
    assign USBPU = 0;
  `endif

  `ifdef SPIPLL
    // PLL for SPI Bus
    wire spi_clock;
    wire spipll_locked;
    spi_pll spll (.clock_in(CLK),
                  .clock_out(spi_clock),
                  .locked(spipll_locked));
  `else
    wire spi_clock = CLK;
  `endif

  // Word handler
  // The system operates on 64 bit little endian words
  // This should make it easier to send 64 bit chunks from the host controller
  reg [63:0] word_send_data;
  reg [63:0] word_data_received;
  wire word_received;
  SPIWord word_proc (
                .clk(spi_clock),
                .SCK(SCK),
                .CS(CS),
                .COPI(COPI),
                .CIPO(CIPO),
                .word_send_data(word_send_data),
                .word_received(word_received),
                .word_data_received(word_data_received));

  //Reset
  wire resetn;
  reg [7:0] resetn_counter = 0;
  assign resetn = &resetn_counter;
  always @(posedge CLK) begin
    if (!resetn) resetn_counter <= resetn_counter + 1'b1;
  end
  wire reset = resetn;

  // Stepper Setup
  // TODO: Generate statement?
  reg [2:0] microsteps = 2;
  reg [7:0] current = 140;
  reg [9:0] config_offtime = 810;
  reg [7:0] config_blanktime = 27;
  reg [9:0] config_fastdecay_threshold = 706;
  reg [7:0] config_minimum_on_time = 54;
  reg [10:0] config_current_threshold = 1024;
  reg [7:0] config_chargepump_period = 91;
  reg config_invert_highside = 0;
  reg config_invert_lowside = 0;
  reg [511:0] cos_table;

  initial begin
    cos_table	 [ 	7	 : 	0	 ] = 	255	;
    cos_table	 [ 	15	 : 	8	 ] = 	255	;
    cos_table	 [ 	23	 : 	16	 ] = 	255	;
    cos_table	 [ 	31	 : 	24	 ] = 	254	;
    cos_table	 [ 	39	 : 	32	 ] = 	254	;
    cos_table	 [ 	47	 : 	40	 ] = 	253	;
    cos_table	 [ 	55	 : 	48	 ] = 	252	;
    cos_table	 [ 	63	 : 	56	 ] = 	251	;
    cos_table	 [ 	71	 : 	64	 ] = 	250	;
    cos_table	 [ 	79	 : 	72	 ] = 	249	;
    cos_table	 [ 	87	 : 	80	 ] = 	247	;
    cos_table	 [ 	95	 : 	88	 ] = 	246	;
    cos_table	 [ 	103	 : 	96	 ] = 	244	;
    cos_table	 [ 	111	 : 	104	 ] = 	242	;
    cos_table	 [ 	119	 : 	112	 ] = 	240	;
    cos_table	 [ 	127	 : 	120	 ] = 	238	;
    cos_table	 [ 	135	 : 	128	 ] = 	236	;
    cos_table	 [ 	143	 : 	136	 ] = 	233	;
    cos_table	 [ 	151	 : 	144	 ] = 	231	;
    cos_table	 [ 	159	 : 	152	 ] = 	228	;
    cos_table	 [ 	167	 : 	160	 ] = 	225	;
    cos_table	 [ 	175	 : 	168	 ] = 	222	;
    cos_table	 [ 	183	 : 	176	 ] = 	219	;
    cos_table	 [ 	191	 : 	184	 ] = 	215	;
    cos_table	 [ 	199	 : 	192	 ] = 	212	;
    cos_table	 [ 	207	 : 	200	 ] = 	208	;
    cos_table	 [ 	215	 : 	208	 ] = 	205	;
    cos_table	 [ 	223	 : 	216	 ] = 	201	;
    cos_table	 [ 	231	 : 	224	 ] = 	197	;
    cos_table	 [ 	239	 : 	232	 ] = 	193	;
    cos_table	 [ 	247	 : 	240	 ] = 	189	;
    cos_table	 [ 	255	 : 	248	 ] = 	185	;
    cos_table	 [ 	263	 : 	256	 ] = 	180	;
    cos_table	 [ 	271	 : 	264	 ] = 	176	;
    cos_table	 [ 	279	 : 	272	 ] = 	171	;
    cos_table	 [ 	287	 : 	280	 ] = 	167	;
    cos_table	 [ 	295	 : 	288	 ] = 	162	;
    cos_table	 [ 	303	 : 	296	 ] = 	157	;
    cos_table	 [ 	311	 : 	304	 ] = 	152	;
    cos_table	 [ 	319	 : 	312	 ] = 	147	;
    cos_table	 [ 	327	 : 	320	 ] = 	142	;
    cos_table	 [ 	335	 : 	328	 ] = 	136	;
    cos_table	 [ 	343	 : 	336	 ] = 	131	;
    cos_table	 [ 	351	 : 	344	 ] = 	126	;
    cos_table	 [ 	359	 : 	352	 ] = 	120	;
    cos_table	 [ 	367	 : 	360	 ] = 	115	;
    cos_table	 [ 	375	 : 	368	 ] = 	109	;
    cos_table	 [ 	383	 : 	376	 ] = 	103	;
    cos_table	 [ 	391	 : 	384	 ] = 	98	;
    cos_table	 [ 	399	 : 	392	 ] = 	92	;
    cos_table	 [ 	407	 : 	400	 ] = 	86	;
    cos_table	 [ 	415	 : 	408	 ] = 	80	;
    cos_table	 [ 	423	 : 	416	 ] = 	74	;
    cos_table	 [ 	431	 : 	424	 ] = 	68	;
    cos_table	 [ 	439	 : 	432	 ] = 	62	;
    cos_table	 [ 	447	 : 	440	 ] = 	56	;
    cos_table	 [ 	455	 : 	448	 ] = 	50	;
    cos_table	 [ 	463	 : 	456	 ] = 	44	;
    cos_table	 [ 	471	 : 	464	 ] = 	37	;
    cos_table	 [ 	479	 : 	472	 ] = 	31	;
    cos_table	 [ 	487	 : 	480	 ] = 	25	;
    cos_table	 [ 	495	 : 	488	 ] = 	19	;
    cos_table	 [ 	503	 : 	496	 ] = 	13	;
    cos_table	 [ 	511	 : 	504	 ] = 	6	;
  end

  wire step;
  wire dir;
  reg enable;

  `ifdef DUAL_HBRIDGE
  DualHBridge s0 (.phase_a1 (PHASE_A1[1]),
                .phase_a2 (PHASE_A2[1]),
                .phase_b1 (PHASE_B1[1]),
                .phase_b2 (PHASE_B2[1]),
                .vref_a (VREF_A[1]),
                .vref_b (VREF_B[1]),
                .step (step),
                .dir (dir),
                .enable (enable),
                .microsteps (microsteps),
                .current (current),
                .microsteps (microsteps));
  `endif

  `ifdef ULTIBRIDGE
    microstepper_top microstepper0(
      .clk(CLK),
      .resetn( resetn),
      .s_l ({PHASE_B2[1], PHASE_B1[1], PHASE_A2[1], PHASE_A1[1]}),
      .s_h ({PHASE_B2_H[1], PHASE_B1_H[1], PHASE_A2_H[1], PHASE_A1_H[1]}),
      .analog_cmp1 (analog_cmp1),
      .analog_out1 (analog_out1),
      .analog_cmp2 (analog_cmp2),
      .analog_out2 (analog_out2),
      .chargepump_pin (CHARGEPUMP),
      .config_offtime (config_offtime),
      .config_blanktime (config_blanktime),
      .config_fastdecay_threshold (config_fastdecay_threshold),
      .config_minimum_on_time (config_minimum_on_time),
      .config_current_threshold (config_current_threshold),
      .config_chargepump_period (config_chargepump_period),
      .config_invert_highside (config_invert_highside),
      .config_invert_lowside (config_invert_lowside),
      .cos_table (cos_table),
      .step (step),
      .dir (dir),
      .enable(enable),
      );
  `endif


  //
  // Encoder
  //
  reg signed [63:0] encoder_count;
  reg signed [63:0] encoder_store; // Snapshot for SPI comms
  reg [7:0] encoder_multiplier = 1;
  wire encoder_fault;
  `ifdef QUAD_ENC
    // TODO: For ... generate
    quad_enc #(.encbits(64)) encoder0
    (
      .resetn(reset),
      .clk(CLK),
      .a(ENC_A[1]),
      .b(ENC_B[1]),
      .faultn(encoder_fault),
      .count(encoder_count),
      .multiplier(encoder_multiplier));
  `endif

  //
  // State Machine for handling SPI Messages
  //

  reg [7:0] message_word_count = 0;
  reg [7:0] message_header;
  reg [`MOVE_BUFFER_BITS:0] writemoveind = 0;

  // check if the Header indicated multi-word transfer
  wire awaiting_more_words = (message_header == `CMD_COORDINATED_STEP) |
                             (message_header == `CMD_API_VERSION);

  always @(posedge word_received) begin

    // Zero out send data register
    word_send_data <= 64'b0;

    // Header Processing
    if (!awaiting_more_words) begin

      // Save CMD header incase multi word transaction
      message_header <= word_data_received[63:56]; // Header is 8 MSB

      // First word so message count zero
      message_word_count <= 1;

      case (word_data_received[63:56])

        // Coordinated Move
        `CMD_COORDINATED_STEP: begin

          // Get Direction Bits
          dir_r[writemoveind] <= word_data_received[0];

          // Store encoder values across all axes Now
          encoder_store <= encoder_count;

        end

        // Motor Enable/disable
        `CMD_MOTOR_ENABLE: begin
          enable <= word_data_received[0];
        end

        // Clock divisor (24 bit)
        `CMD_CLK_DIVISOR: begin
          clock_divisor[7:0] <= word_data_received[7:0];
        end

        // Set Microstepping
        `CMD_MOTORCONFIG: begin
          // TODO needs to be power of two
          current[7:0] <= word_data_received[15:8];
          microsteps[2:0] <= word_data_received[2:0];
        end

        // Set Microstepping Parameters
        `CMD_MICROSTEPPER_CONFIG: begin
          config_offtime[9:0] <= word_data_received[39:30];
          config_blanktime[7:0] <= word_data_received[29:22];
          config_fastdecay_threshold[9:0] <= word_data_received[21:12];
          config_minimum_on_time[7:0] <= word_data_received[18:11];
          config_current_threshold[10:0] <= word_data_received[10:0];
        end

        // Set chargepump period
        `CMD_CHARGEPUMP: begin
          config_chargepump_period[7:0] <= word_data_received[7:0];
        end

        // Invert Bridge outputs
        `CMD_BRIDGEINVERT: begin
          config_invert_highside <= word_data_received[1];
          config_invert_lowside <= word_data_received[0];
        end

        // Write to Cosine Table
        `CMD_COSINE_CONFIG: begin
          //config_cosine_table[word_data_received[35:32]] <= word_data_received[31:0];
          cos_table[word_data_received[37:32]] <= word_data_received[7:0];
          //cos_table[word_data_received[35:32]+3] <= word_data_received[31:25];
          //cos_table[word_data_received[35:32]+2] <= word_data_received[24:16];
          //cos_table[word_data_received[35:32]+1] <= word_data_received[15:8];
          //cos_table[word_data_received[35:32]] <= word_data_received[7:0];
        end

        // API Version
        `CMD_API_VERSION: begin
          word_send_data[7:0] <= `VERSION_PATCH;
          word_send_data[15:8] <= `VERSION_MINOR;
          word_send_data[23:16] <= `VERSION_MAJOR;
        end

      endcase

    // Addition Word Processing
    end else begin

      message_word_count <= message_word_count + 1;

      case (message_header)
        // Move Routine
        `CMD_COORDINATED_STEP: begin
          // the first non-header word is the move duration
          case (message_word_count)
            1: begin
              move_duration[writemoveind][63:0] <= word_data_received[63:0];
              //word_send_data[63:0] = last_steps_taken[63:0]; // Prep to send steps
            end
            2: begin
              increment[writemoveind][63:0] <= word_data_received[63:0];
              word_send_data[63:0] <= encoder_store[63:0]; // Prep to send encoder read
            end
            3: begin
                incrementincrement[writemoveind][63:0] <= word_data_received[63:0];
                message_word_count <= 0;
                stepready[writemoveind] <= ~stepready[writemoveind];
                writemoveind <= writemoveind + 1'b1;
                message_header <= 8'b0; // Reset Message Header
                `ifdef FORMAL
                  assert(writemoveind <= `MOVE_BUFFER_SIZE);
                `endif
            end
          endcase
        end
      endcase
    end
  end

  //
  // Stepper Timing Routine
  //

  // coordinated move execution

  reg [`MOVE_BUFFER_BITS:0] moveind = 0; // Move index cursor

  // Latching mechanism for engaging the buffered move.
  reg [`MOVE_BUFFER_SIZE:0] stepready;
  reg [`MOVE_BUFFER_SIZE:0] stepfinished;

  reg [63:0] move_duration [`MOVE_BUFFER_SIZE:0];
  reg [7:0] clock_divisor = 40;  // should be 40 for 400 khz at 16Mhz Clk
  reg [`MOVE_BUFFER_SIZE:0] dir_r;

  reg [63:0] tickdowncount;  // move down count (clock cycles)
  reg [7:0] clkaccum = 8'b1;  // intra-tick accumulator

  reg signed [63:0] substep_accumulator = 0; // typemax(Int64) - 100 for buffer
  reg signed [63:0] increment_r;
  reg signed [63:0] increment [`MOVE_BUFFER_SIZE:0];
  reg signed [63:0] incrementincrement [`MOVE_BUFFER_SIZE:0];

  reg finishedmove = 1; // flag inidicating a move has been finished, so load next
  wire processing_move = (stepfinished[moveind] ^ stepready[moveind]);
  wire loading_move = finishedmove & processing_move;
  wire executing_move = !finishedmove & processing_move;

  // Implement flow control and event pins if specified
  `ifdef BUFFER_DTR
    assign BUFFER_DTR = ~(~stepfinished == stepready);
  `endif

  `ifdef MOVE_DONE
    reg move_done_r = 0;
    assign MOVE_DONE = move_done_r;
    always @(posedge finishedmove)
      move_done_r = ~move_done_r;
  `endif


  `ifndef STEPINPUT
    assign dir = dir_r[moveind]; // set direction
    assign step = (substep_accumulator > 0);
  `else
    assign dir = dir_r[moveind] | DIRINPUT; // set direction
    assign step = (substep_accumulator > 0) | STEPINPUT;
  `endif

  `ifdef STEPOUTPUT
    assign STEPOUTPUT = step;
    assign DIROUTPUT = dir;
  `endif

  always @(posedge CLK) begin

    // HALT line (active low) then reset buffer latch and index
    // TODO: Should substep accumulator reset?
    `ifdef HALT
      if (!HALT) begin
        moveind <= writemoveind; // match buffer cursor
        stepfinished <= stepready; // reset latch
        finishedmove <= 1; // Puts us back in loading_move
      end
    `endif

    // Load up the move duration
    if (loading_move) begin
      tickdowncount <= move_duration[moveind];
      finishedmove <= 0;
      increment_r <= increment[moveind];
    end

    // check if this move has been done before
    if(executing_move) begin

      // Step taken, rollback accumulator
      if (substep_accumulator > 0) begin
        substep_accumulator <= substep_accumulator - 64'h7fffffffffffff9b;
      end

      // DDA clock divisor
      clkaccum <= clkaccum - 8'b1;
      if (clkaccum == 8'b0) begin

        increment_r <= increment_r + incrementincrement[moveind];
        substep_accumulator <= substep_accumulator + increment_r;

        // Increment tick accumulators
        clkaccum <= clock_divisor;
        tickdowncount <= tickdowncount - 1'b1;
        // See if we finished the segment and incrment the buffer
        if(tickdowncount == 0) begin
          stepfinished[moveind] <= ~stepfinished[moveind];
          moveind <= moveind + 1'b1;
          finishedmove <= 1;
          `ifdef FORMAL
            assert(moveind <= `MOVE_BUFFER_SIZE);
          `endif
        end
      end
    end
  end
endmodule
