RAPcores/rapcores/src/microstepper/chargepump.v

// SPDX-License-Identifier: ISC
`default_nettype none

module chargepump (
    input  clk,
    input  resetn,
    input  [7:0] period,
    output chargepump_pin
);

  reg [7:0] cp_counter;
  reg       chargepump;
  assign chargepump_pin = chargepump;
  always @(posedge clk) begin
    if (!resetn) begin
      cp_counter <= 0;
      chargepump <= 0;
    end else begin
      cp_counter <= cp_counter + 1'b1;

      if (cp_counter == period) begin
        cp_counter <= 0;
        chargepump <= ~chargepump;
      end
    end
  end

endmodule
