RAPcores/rapcores/(commit log)

2019-09-29 fault now wire. add gitignore.
2019-10-08 added spi. compiles. not tested. still has previous warnings.
2020-02-12 spi and encoder working with 32 bit send buffer
2020-02-12 add makefile and pin file for ecp5
2020-03-20 8 bit spi interpreter responding with 32bit data + 8 bit last command.
2020-03-20 40 bit spi receiving works
2020-03-23 reset and multiplier logic is working
    [quad_enc.v]
2020-03-25 interrupt logic prevents skipped steps at slow speeds
2020-07-24 implement basic case table for stepper and visualize with LED
2020-07-24 start breaking stepper into a module
2020-07-24 ignore timing, just attempt to get sequencing correct
    [top.v]
2020-07-24 wire up pwm
2020-07-27 [build] move pin defs to a folder and import the makefile for the stepping code
2020-07-27 breakout stepper code
2020-07-27 init spi, untested
2020-07-30 try to simplify spi implementation a bit
2020-07-31 Revert "try to simplify spi implementation a bit"
    This reverts commit dd41bd1b61bf86488f611e29358b4faea54e0581.
    [spi.v, top.v]
2020-08-07 some stepper module improvements, shoudl make it easier for hbridge fo smart stepper switch
2020-08-10 init formal verification and make fixes for unboundedness
    [spi.v, stepper.v, top.v]
2020-08-11 add MIT licensed SPI implementation
2020-08-12 clear out some warnings in stepper routine
2020-08-13 working step incrmentor, not yet hooked up to SPI
2020-08-13 enable SPI for stepping algo
2020-08-17 wip SPI backfeed
2020-08-17 finish swap out for MIT licensed SPI implmentation, should address backfeed mailboxing issue
    [spi.v]
2020-08-17 rm old future spi file
2020-08-19 add board map for rapbo stepper
2020-08-19 rapbo pins. SPI signal rename CIPO COPI.
2020-08-19 stepper timer: rename some reg for clarity
2020-08-21 update pin names
2020-08-25 Implement SPI Transmit
    Due to the limitations and possible incorrectness of the selected implementation, the core Byte sender had to be redesigned.
    This implements a much simpler mechanism for crossing the clock domain. It also aleviated CIPO preload issues by mapping
    the tx_byte register directly to the wire and tristates the pin. Given we are likely to have all TX data a priori this
    should be fine. E.g. all TX Bytes are register reads. However this may cause issues as the next byte is started at the
    falling edge without any clock delay. This trips up my logic analyser.
    [spi.v, tinyfpga.pcf, top.v]
2020-08-31 remove pwm pins from stepper. Will controll the lines direct
2020-08-31 [stepper] add direction support to DualHBridge module and SPI protocol
2020-08-31 [stepper] refactor stepper control to use table in prep for microsteps
2020-09-01 [stepper] use bit shifts for step multiple
2020-09-01 [stepper] clean up assignments and add comments
2020-09-15 [encoder] enable send
2020-09-16 [stepper] add failing formal case
    [stepper.v]
2020-09-26 [build] init board specific verilog config
2020-09-26 [build] propogate board info to verilog from make and init ecp5
2020-09-26 [build] simplify board specific verilog include
2020-09-29 [docs] update dev docs BOARD structure
2020-09-30 [build] fix make if board unspecified
2020-09-30 [stepper] further improve structure of stepper code by using more continuous assigns
2020-09-30 [stepper] trigger BRAM inference
2020-09-30 [stepper] support enable/disable
2020-09-30 Use macro defines to keep track of SPI header constants
2020-10-01 [formal] add constants file and failing case in SPI
    [spi.v]
2020-10-06 [docs] add SPI version description and init index
2020-10-08 [spi] improve word slice performance
2020-10-08 [perf] switch some regs to wires for higher freq ceiling
2020-10-08 [spi] Use a PLL to support higher SPI frequencies. Tests well with raspi at 16Mhz SCK and 64Mhz PLL, but noise seems an issue at 32Mhz SPI and with higher PLL frequencies (70-128mhz tested).
    [top.v]
2020-10-12 [spi] disable PLL clock until metastability is resolved
    [top.v]
2020-10-12 [stepper] set increment sign on wire
2020-10-12 [steptimer] improve logic flow, at ~1700 LUT and 31Mhz on ice40 now
2020-10-13 [steptimer] fix substep reset
    [top.v]
2020-10-13 [statemachine] several pipeline improvements and cleanup encoder read/send
2020-10-14 [docs] breakout board config and make some clarifications
2020-10-15 [steptimer] add a BUFFER_DTR pin, partially addresses #19
2020-10-15 [event pins] add MOVE_DONE pin to toggle per #19
2020-10-19 [stepper] initial semantic changes for multiaxis
2020-10-21 add HALT pin to stop move + clear buf, finishes #19.
2020-10-21 conditionally use HALT pin and add comments
2020-10-22 [steptimer] switch downcount to 32 bit per spec and move into the header word
2020-10-22 [encoder] switch count to 32 bit
2020-10-22 [encoder] improve pipelining
2020-10-22 [encoder] remove unreachable fault logic and add formal assertion
2020-10-22 [protocol] add step encoder support
2020-10-22 [docs] update spi protocol docs
2020-10-26 Revert "Change encoders to 32 bits"
    [quad_enc.v, stepper.v, top.v]
2020-10-28 add rapbo pin map
2020-10-28 [ci] add ulx3s to ci flow
2020-10-29 [stepper] init vrefs
2020-10-30 [stepper] add simple current limit
2020-10-30 [docs] add VREF_<Phase> pins to DUAL_HBRIDGE pin requirements
2020-10-30 [stepper] forgot to add pwm file
2020-10-30 [ulx3s] add vref to stepper
2020-10-30 [formal] add pwm
2020-11-02 [pwm] fix bug when zero or bit max
    [pwm.v]
2020-11-11 [docs] edits and add motor control stub
2020-11-12 add current scaling threshold parameter for microstepper
2020-11-12 for microstepper use an array table instead of case statement for cosine lookup
2020-11-12 microstepper: add formal verify check that H bridge doesn't shoot through
    [microstepper_top.v]
2020-11-12 microstepper: refactor off timers into generic timer module
2020-11-12 microstepper: add width parameter to timer module
2020-11-12 microstepper: refactor blank timers into timer module
2020-11-12 [ci] add rapbo flow to github actions
2020-11-14 [rapbo] change SPI pins to make them lexographically consistent with the physical pins
2020-11-14 [docs] mention LED
2020-11-16 [docs] add additional entries in spi protocol
2020-11-16 [nix] pin nixpkgs to 20.09
2020-11-17 [spi] add comments
2020-11-28 microstepper: minimum on time should gate the high side mosfets too
2020-11-28 spi microstepper config
2020-11-28 [chargepump] init registers for configurable period
2020-11-28 [chargepump] config period over SPI
2020-11-29 add step/dir input/output and use LEDs to validate DTR signals
2020-11-29 [spi] block out PLL with a seperate define
2020-12-02 timer fixes and missing wires
    [microstepper_control.v, microstepper_top.v, mytimer_10.v, mytimer_8.v]
2020-12-03 [step timer] move to own module
2020-12-04 reset logic for analog out, phase_ct, step dir buffer, instantiation name expansion.
    [analog_out.v, microstepper_control.v, microstepper_top.v]
2020-12-04 [micro stepper] allow default timer width to be set via macro definition
2020-12-04 [docs] add instructions for interactive SPI transfers with RasPi
2020-12-06 default output active high, slow decay on low side, improve testbench motor model
2020-12-07 fix undeclared errors. add default_nettype none.
    [analog_out.v, chargepump.v, cosine.v, microstep_counter.v, microstepper_control.v, microstepper_tb.v, microstepper_top.v, mytimer.v]
2020-12-07 fix merged end comment
    [rapcore.v]
2020-12-10 [spi fsm] fix state error on multi word transaction
    [spi_state_machine.v]
2020-12-13 top level wire defines and input output trailing comma removal;
2020-12-14 sim fix for iverilog "error: reg word_data_received; cannot be driven by primitives or continuous assignment"
    [spi_state_machine.v]
2020-12-15 [testbench] init spi, basic send test
2020-12-16 spi 64bit word wip
2020-12-16 [spi] several initialization fixes
    [spi.v, spi_state_machine.v]
2020-12-17 [fsm/dda/spi] several value initialization fixes
    [dda_timer.v, spi.v, spi_state_machine.v]
2020-12-17 compatability fixes with iverilog
    [dda_timer.v, rapcore.v, spi_state_machine.v]
2020-12-17 wip verilator related fixes
    [cosine.v, macro_params.v, microstepper_top.v, spi.v, spi_state_machine.v]
2020-12-17 added missing faultn wire to microstepper_top instance. commented config_deadtime.
    [microstepper_top.v, rapcore.v]
2020-12-17 fix most or all verilator warnings for 'done' not being used in cell
    [mytimer_8.v]
2020-12-17 add back in off time wires to microstepper_control - wip
2020-12-17 Revert "add back in off time wires to microstepper_control - wip"
    This reverts commit 817efea8da67238ec3622b95cf25a79cf2de5d7d.
    [microstepper_control.v]
2020-12-17 Fix verible lint message: Declared module does not match file name
    [pwm.v, stepper.v]
2020-12-17 fix verible lint: Binary literal is shorter than its declared width
    [dda_timer.v, spi.v]
2020-12-17 alternative fix for iverilog null port error. fixes error in verible lint for comma prefix.
    [dda_timer.v, rapcore.v, spi_state_machine.v]
2020-12-17 add resetn to spi state machine to init variables
    [rapcore.v, spi_state_machine.v]
2020-12-17 add clock to bottom of list as an alternative to using a comma prefix for conditional module arguments. The comma prefix causes a syntax error in verible lint.
    [spi_state_machine.v]
2020-12-17 add resetn to dda_timer
    [dda_timer.v, spi_state_machine.v]
2020-12-17 resetn in spi module. spi resetn non blocking assignments. add clock divisor to reset.
    [dda_timer.v, spi.v, spi_state_machine.v]
2020-12-17 resetn added to SPIWord
    [spi.v, spi_state_machine.v]
2020-12-17 for resetn: remove old initial block
    [spi_state_machine.v]
2020-12-17 moved more init variables into reset handler
    [spi_state_machine.v]
2020-12-17 fix word_data_received init on reset put in wrong always block
    [spi_state_machine.v]
2020-12-17 fix reset init in remaining areas.
    [mytimer.v, mytimer_10.v, mytimer_8.v, pwm.v, rapcore.v, spi_state_machine.v]
2020-12-17 fix nreset and remove quad enc multiplier
    [quad_enc.v, stepper.v]
2020-12-17 [tb] update spi for reset changes
    [spi_state_machine_tb.v, spi_tb.v]
2020-12-17 minor fixes to reset assigns for testbench
    [dda_timer.v, pwm.v, spi_state_machine.v]
2020-12-18 iverilog NULL port fixes: mitigate preprocessor leaving a trailing comma
    [rapcore.v]
2020-12-18 remove current_sum_polarity from microstepper_tb top
2020-12-18 comment the hbridge motor logic
2020-12-18 start reset counter after resetn_in rises
    [rapcore.v]
2020-12-18 add Jasons fault fixes
    [microstepper_control.v]
2020-12-18 use resetn_in to reset the resetn_counter
    [rapcore.v]
2020-12-18 update rapcore testbench for reset delay. approximately working now
    [dda_timer.v, rapcore_harness_tb.v]
2020-12-18 [tb] fix sim for iverilog
    [rapcore_harness_tb.v]
2020-12-18 [rapcore tb] fix halt wire
    [rapcore_harness_tb.v]
2020-12-18 wire microstepper to harness
2020-12-19 fixes for rapcore harness with iverilog
    [rapcore_harness_tb.v]
2020-12-19 [tb] fix boot done in on local RTL sim
    [rapcore_tb.v]
2020-12-21 fix assignments to async
    [spi_state_machine.v]
2020-12-21 several initialization fixes on resetn
    [quad_enc.v, spi_state_machine.v]
2020-12-21 fix bitwidth on encoder count-zero
    [quad_enc.v]
2020-12-21 [tb] add encoder to rapcore harness
2020-12-21 add default board config options for bridge inverting
    [mpw_one_defines.v, rapbo.v, spi_state_machine.v]
2020-12-22 [stepper] fix step regression
    [stepper.v]
2020-12-23 fix formal verification. it was no longer checking in the correct scope after features were added.
    [microstepper_control.v]
2020-12-23 seperate out inverting logic so formal verify can check up to that point
    [microstepper_control.v]
2021-01-14 [multiaxis] spi word handling
2021-01-14 [mutliaxis] fixes and test bench updates
    [rapcore_harness_tb.v, spi_state_machine.v]
2021-01-14 [multiaxis] tb and assignment fixes
    [rapcore_tb.v, spi_state_machine.v]
2021-01-14 [ulx3s] pin map fixes for multiaxis
2021-01-14 [testbench] multiaxis wire updates
2021-01-14 [docs] mention MOTOR_COUNT define
2021-01-14 [rapbo] pin fixes for multiaxis
    [rapcore.v]
2021-01-15 [dda] move clock divisor to a seperate module for all channels. Should reduce drift
    [clock_divider.v, dda_timer.v, spi_state_machine.v]
2021-01-19 [dda] make timer and buffering logic common outside dda_timer
2021-01-19 [dda/spi] allow move duration to be specified and default to 32 bits
2021-01-20 [encoder] add internal step counter and integrate with SPI FSM, closes #135
2021-01-20 [ecp5evn] init
    [ecp5evn.cfg]
2021-01-20 [ci] add ecp5evn flow to tests
2021-01-20 [docs] update spi protocol tables
2021-01-20 [docs] mv boards.md -> configuration.md
2021-01-20 [docs] reorganize board configuration docs
2021-02-08 stepper.v -> dual_hbridge.v
2021-02-08 [dualh] add brake mode
2021-02-08 [fsm] fix double define of BUFFER_DTR wire
    [spi_state_machine.v]
2021-02-11 [enc] output step signals internally and support index pin
2021-02-11 [dual h] add current bits as a parameter
2021-02-16 [dual h] add experimental brake during vref off cycle
2021-02-16 [dual h] rework phase polarity in prep for vector model
    [dual_hbridge.v]
2021-02-16 [tb] add simple pwm tb
2021-02-16 [dual h] fix cosine polarity
    [dual_hbridge.v]
2021-02-16 [dualh] use single pwm for the current multiple
2021-02-16 [dualh] cleanup brake mode when VREF is off
2021-02-16 [dualh] use views rather than bitshifts to avoid bit width warnings
    [dual_hbridge.v, rapcore.v]
2021-02-16 [dualh] additional width and declaration fixes via triple-check
    [dual_hbridge.v, spi_state_machine.v]
2021-02-16 [pwm] implement a specific PLL for use in PWM
2021-02-16 [dualh] use multiplier for current scaling (dsp todo)
2021-02-17 [docs] minor corrections to motor control
2021-02-19 [major reorg] fsm and rapcore top reorg
    this is the first part of a refactor for better multiaxis
    moves stepper modules inside FSM
    moves PLLs into top level
2021-02-20 collapse step counter into the stepper driver
2021-02-20 fixup define-contingent wire declarations
    [rapcore.v]
2021-02-20 seperate SPI bus from FSM
2021-02-20 [spi] move word recived clocking into module pending CDC rework
    [rapcore.v, spi.v]
2021-02-20 [spi] fix tabination
2021-02-20 [spi] cleanup multi-word handling
2021-02-20 [spi] fix duplicate wire declaration
    [spi.v]
2021-02-20 [spi] simplify FIFOs based on nandland implementation
2021-02-20 [dda] fix timer jitter, close #146
    [clock_divider.v]
2021-02-20 allow for configurable default microsteps and current
2021-02-23 [build] add stat target and experimental custom flow for ice40
2021-02-23 add encoder and stepper fault register reads to SPI protocol
2021-02-23 support multiple quad encoders
2021-02-24 [pwm] add resetable as a parameter
    [pwm.v]
2021-02-24 replace CMD macros defines with localparams, ref #133
    [spi_state_machine.v]
2021-02-24 allow encoder bits to be configurable
2021-02-24 [formal] use board configurations again
2021-02-26 wip: gowin support, broken on tristate
    [gowin_example.v]
2021-02-26 [build] remove generated/board.v and replace with -D flag
2021-02-28 init four wire h bridge control
2021-02-28 [spi] add 32 bit modes
2021-02-28 [spi] fix repetition operator
    [spi.v]
2021-02-28 [tb] fixup spi parameters
    [spi_tb.v]
2021-02-28 [spi] wip: 32 word handling
2021-02-28 [tb] update dual h for wire changes
2021-03-01 [tinyfpgabx] four wire bridge control, use vref for quad enc
2021-03-01 [spi] return to triple buffered edge detector fixes #172
    [edge_detector.v, spi.v]
2021-03-01 [edge detect] fix falling edge tribuf
    [edge_detector.v]
2021-03-01 [enc] fix capture and output in state machine
    [spi_state_machine.v]
2021-03-04 [dualh] wire up encoder feedback
2021-03-04 [dualh/pwm] add delayed PWM and use to center align on VREF
2021-03-04 resize pwm_delayed port and cleanup dualH logic a bit
2021-03-05 [docs] init motoring quadrants and control hierarchy sections
2021-03-07 [tachi] dry run of synth/PNR with preliminary pinouts, CLK/SPI TODO
2021-03-12 [svm] make center aligned PWM optional and explain
2021-03-16 [lint] fix comments where WIDTH linting was not eenabled around blocks
    [spi_state_machine.v]
2021-03-16 [lint] partial fix for width issues
    [spi_state_machine.v]
2021-03-16 correctly size step encoder, fixes warning
    [spi_state_machine.v]
2021-03-16 [lint] fix width issue
    [spi_state_machine.v]
2021-03-16 [fsm] fix channel selection in motor config
    [spi_state_machine.v]
2021-03-18 [tb] update for four wire drive
2021-03-26 [docs] add motor model from Bodson paper
2021-03-27 tag some wires with onehot attribute -> better nextpnr frequency
2021-04-02 [pwm] use a single parametric module for delayed/normal, and simplify SVM
2021-04-04 [enc] misc fixes, enable fault read, enable specific channel read
    [quad_enc.v, spi_state_machine.v]
2021-04-04 [enc] needs-test: velocity
2021-04-05 [protocol] fix encoder readback width
    [spi_state_machine.v]
2021-04-08 [spi] fix preload issue
    [spi.v]
2021-04-09 [metastable fix] Clock in CS in SPI
    [spi.v]
2021-04-09 [spi] additional metastability fixes
    [edge_detector.v, spi.v]
2021-04-20 propogate encoder_velocity_bits
2021-04-21 [fsm] fix enc velocity bits width
    [spi_state_machine.v]
2021-05-05 [spi] simplify variable word size to byte handling
2021-05-05 [spi] simplify paramtrics
2021-05-07 corrections to phase offsets and bit widths
    [dual_hbridge.v, space_vector_modulator.v]
2021-05-11 improve propogation of current_bits
2021-05-24 init with SPI test
2021-05-24 scope spi parameters into struct
2021-05-24 24 to 32 bit fixes
    [librapcore.h, rapcore-cli.c]
2021-05-24 [cli] add device flag
2021-05-24 encoder stream
2021-05-26 [docs] update motor control
2021-06-23 frame out for config reg
2021-06-23 init DMA command, trim old commands in favor of status registers
2021-06-23 add config reg to DMA command
2021-06-23 [dma] minor fixups
2021-06-23 [fsm] error on invalid parameters
    [spi_state_machine.v]
2021-06-29 update docs for reg map and SPI protocol adjustments
2021-07-17 [pip] pin versions
2021-07-19 initialize experimental fixed point scheme
    [dda_timer.v, dual_hbridge.v, spi_state_machine.v]
2021-07-21 [docs] collapse CI flow into single environment
2021-07-26 reduce reset timer logic
    [rapcore.v]
2021-07-27 [regmap] align on encoders and motors
2021-11-25 [nix] make docs=false default in shell (#230)
    * [nix] make docs=false default in shell
    * [ci] pin push-action changes
    * [ci] pin push-action changes
    * [ci] bump install-nix-action
    * [ci] bump checkout action
    * [ci] downgrade checkout action
    * [ci] downgrade checkout action
    * try
    * try
    * [nix] fix fetchGit
    * refs
    * wip
